id8-engineering/seven-hardware/(notices)

Notices in the files:
kicad/seven.kicad_pcb:
Licensed under CERN-OHL-P v2
